Ygreece/UNO_DHT22_OLED/(commit log)

2026-09-16 整理DHT22课程设计材料并脱敏
    [温湿度监测系统实验记录表_实测数据_三点统计版_脱敏版.xlsx]
2026-09-17 feat: 增加蓝牙校时与分时阈值切换
    - TIME HH:MM[:SS] 校准时间，仅用 millis() 推算，无需新增模块
    - 按时段自动切换温度阈值：上午 25/30、下午 23/28、夜间 12/15 摄氏度
    - 湿度阈值全天保持 70/80 %RH；未校时回退 28/30 摄氏度
    - SET DAY|PM|NIGHT W C / SET HUM W C 可在线调整阈值
    - 时段切换后重置报警并按最近有效读数重新判定，回差逻辑沿用
    - 新增低温保护：不高于 8 摄氏度置位，回升到 10 摄氏度解除，AUTO 模式下抑制普通通风
    - 严重报警、传感器失效与 FAN ON 的安全风扇逻辑不受影响
    - STATUS 与 OLED 模块页显示时间、时段、当前阈值与 COLD 状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
2026-09-17 fix: harden timed threshold control
    [UNO_DHT22_OLED.ino]
2026-09-17 feat: 第1页显示分时阈值与当前生效阈值
    - P1 页新增三行阈值信息：Now(当前生效) / D(上午) P(下午) / N(夜间)
    - 新增 printThresholdValue()：整数省略小数位，非整数保留 1 位，
    避免四舍五入后显示值与实际报警判据不符
    - 温湿度大字号读数下移，保持第1页原有可读性
    - test/host 新增 8 项断言覆盖阈值显示与小数阈值回显
    验证：宿主机逻辑测试 99 项全通过；Arduino Uno 编译 BUILD OK
    （.data 286 / .text 27636 / .bss 543）
    未验证：实机 OLED 版式需现场目视确认
2026-09-17 docs: 报告补充分时阈值与校时章节、命令表与阈值表，标注未现场验证项
2026-09-17 docs: 功能测试表补充默认阈值与分时阈值的关系说明
2026-09-18 docs: 报告补分时阈值依据文献（变温管理/午前光合峰值/傍晚前降温）并新增参考文献 8-11
2026-09-18 docs: 报告补湿度阈值依据（灰霉病自由水/适宜湿度区间）并新增参考文献 12-13
2026-09-18 docs: 答辩汇报PPT更新分时阈值口径、命令表、测试结果与视频页
2026-09-18 docs: 统一湿度不分时口径并补齐报告与PPT的功能验证说明
    - 报告2.2/4.5节: 湿度阈值说明改为按灰霉病叶面自由水风险取全天统一限值，SET HUM 可修改
    - 报告4.2节: 回差退出条件改为跟随当前湿度阈值(原硬编码65/75 %RH 与可调阈值不符)
    - 报告5.1节: 补充校时与分时功能实测记录
    - PPT(脱敏版)2/6/7/9/16页: 目录改为五项实际验证、报警逻辑改为当前时段阈值、数据记录表口径统一为4项实测通过
2026-09-18 docs: 报告与PPT封面改为模板下划线填空，新增成员分工与硬件实物照片
2026-09-18 docs: 5.3.3 给出可执行的布点准则，5.3.2 补充均方根合成的适用前提
2026-09-18 docs: 删除报告中的调试问题记录章节并更新目录页码
2026-09-18 docs: 删除参考文献[4]主程序自引并同步正文与PPT引用编号
2026-09-18 docs: 参考文献统一 GB/T 7714 格式并删除模板条目，全部表格改为三线表
2026-09-18 docs: 附录B 说明删除与节点需求无关的保留性表述
2026-09-18 docs: 表5-2 标题去掉补测字样
2026-09-18 docs: 插入实测照片（图3-1/4-2/4-3/5-2）并新增第7章成本核算
